CharithDombawala/Soil_Moisture_Meter/images/WhatsApp Image 2023-07-23 at 13.11.01.jpeg

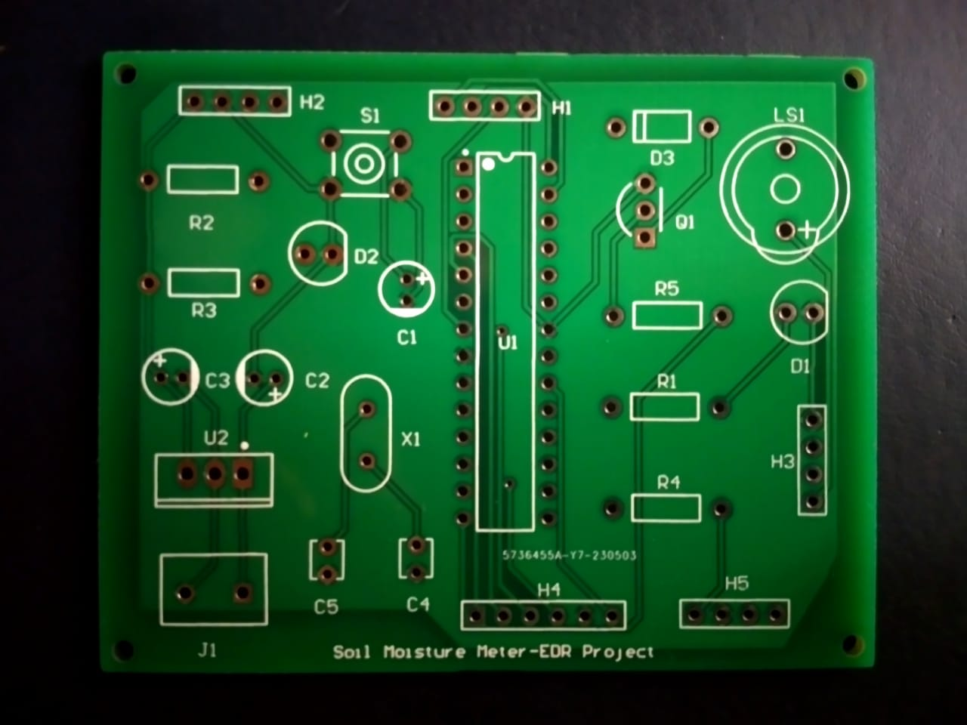
images/WhatsApp Image 2023-07-23 at 13.11.01.jpeg
