CharithDombawala/Soil_Moisture_Meter/README.md

# Soil_moisture_meter
project of electronic design Realization Module. schemetic designs are done by using Easy EDA
