CharithDombawala/Soil_Moisture_Meter/New enclosure Design/Soil Moisture Meter.pdf

# Soil Moisture Meter - Solidworks Design

# Index- 200148M

## - Hand Sketches

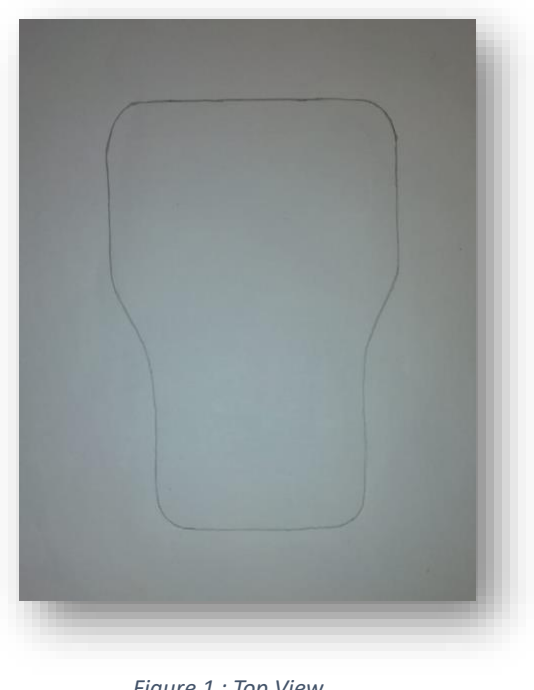
[picture p20: figure]

Figure 1 : Top View

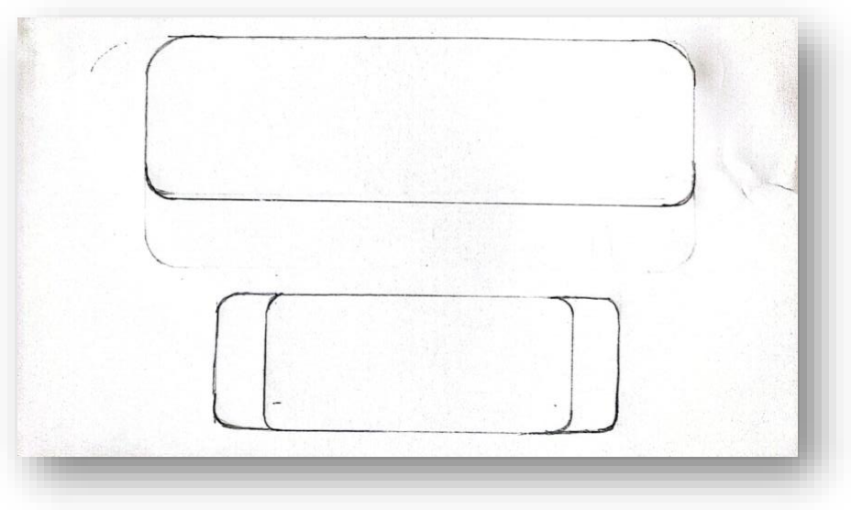
[picture p21: figure]

Figure 2 : Side view and Front view

- Imported Sketches into Solidworks.

### - 3D Design (Assembly)

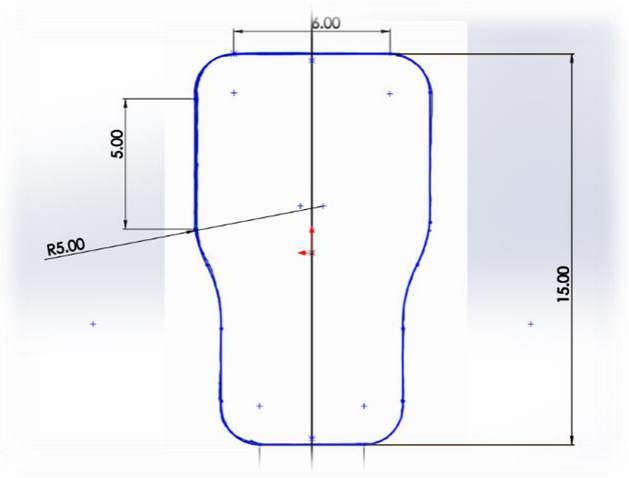
[picture p22: figure]

Figure 3 :imported hand sketch into solidworks

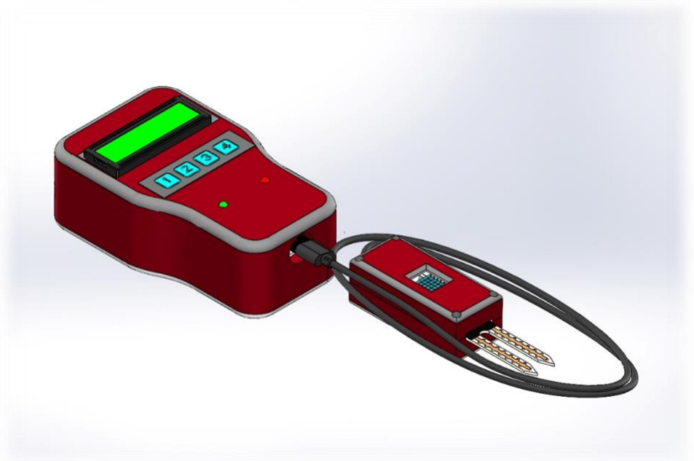
[picture p23: figure]
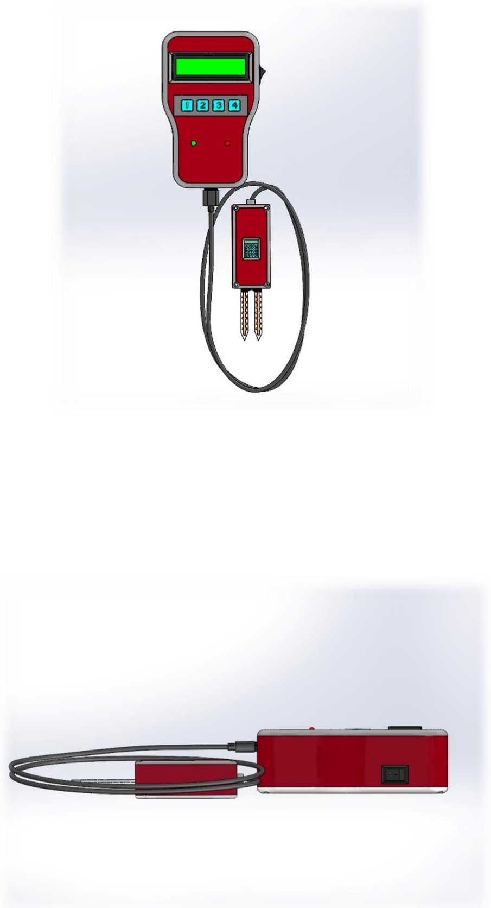
[picture p24: page 3]

### - Solid works Parts

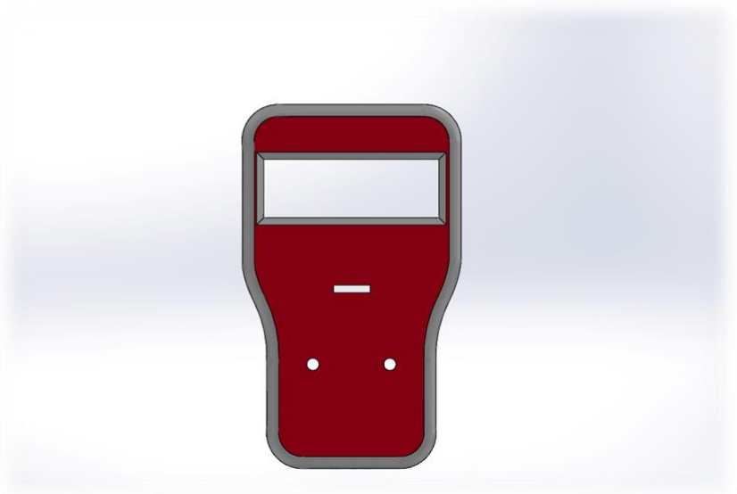
[picture p25: figure]

Figure 1: Top lid

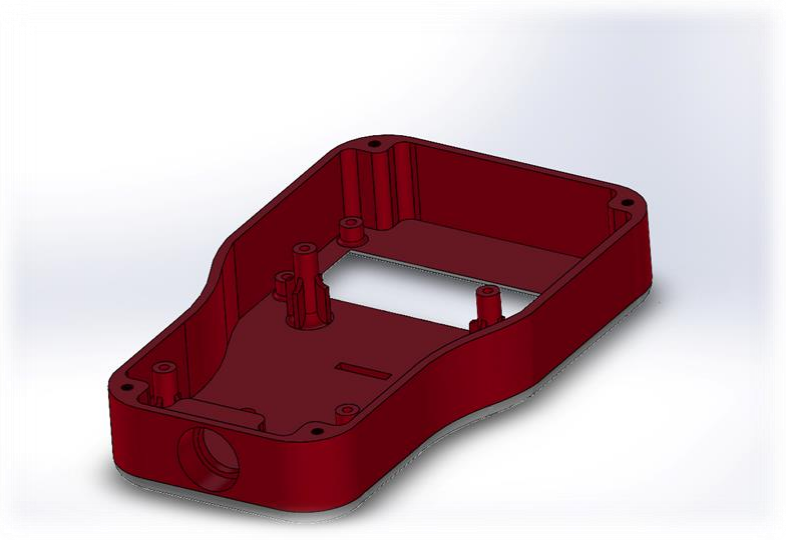
[picture p26: figure]

Figure 2: top lid inside

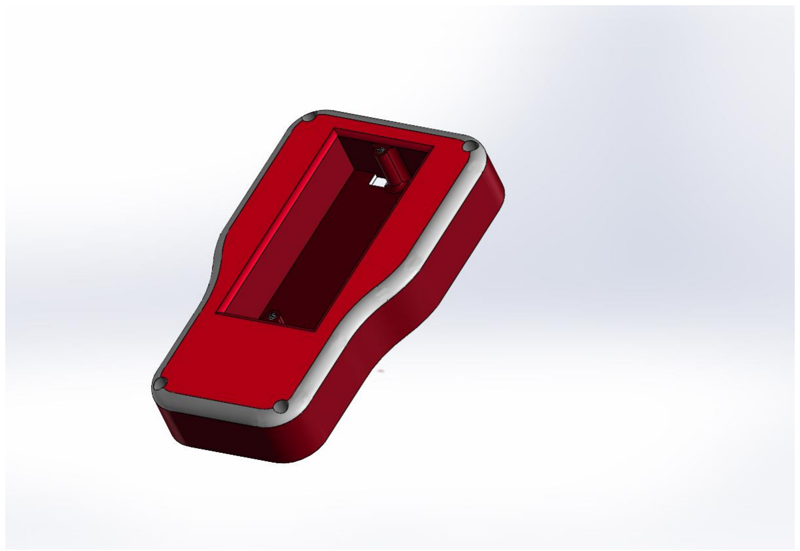
[picture p27: figure]
Figure 3: Top lid (Inside)

Figure 3: bottom lid

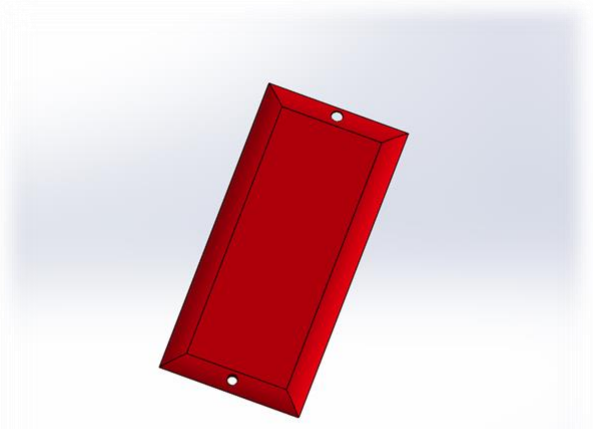
[picture p28: figure]
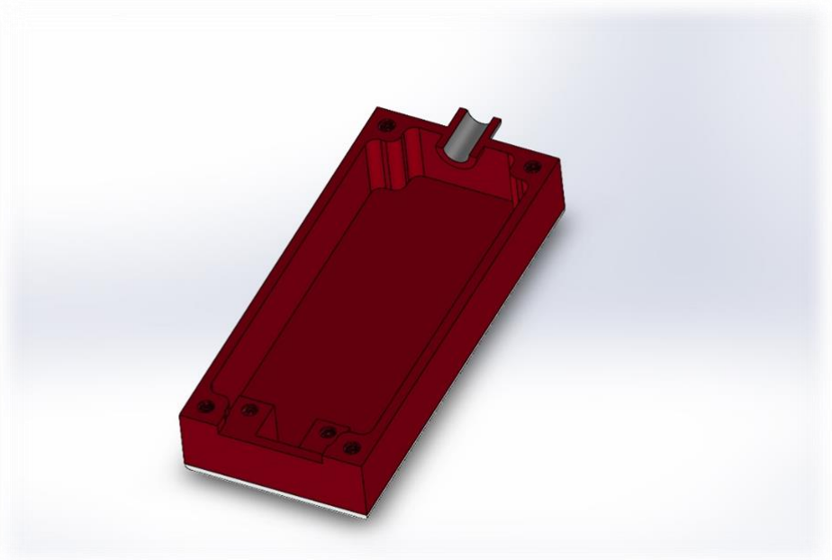
[picture p29: figure]

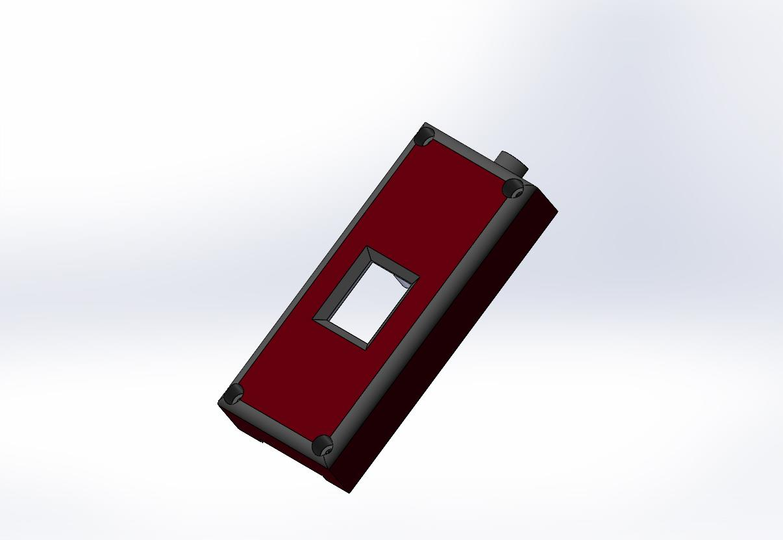
[picture p30: figure]
