CharithDombawala/Soil_Moisture_Meter/images/Screenshot 2023-07-23 112400.png

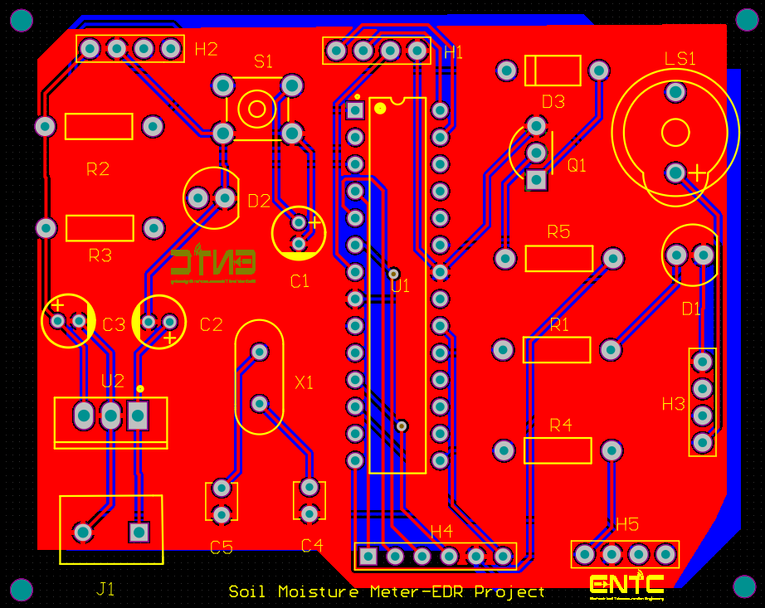
images/Screenshot 2023-07-23 112400.png
