CharithDombawala/Soil_Moisture_Meter/images/WhatsApp Image 2023-07-23 at 12.05.49.jpeg

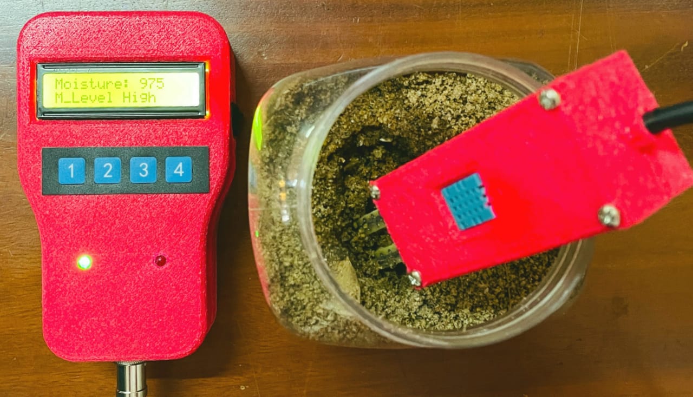
images/WhatsApp Image 2023-07-23 at 12.05.49.jpeg
