CharithDombawala/Soil_Moisture_Meter/New enclosure Design/sw photos/4.JPG

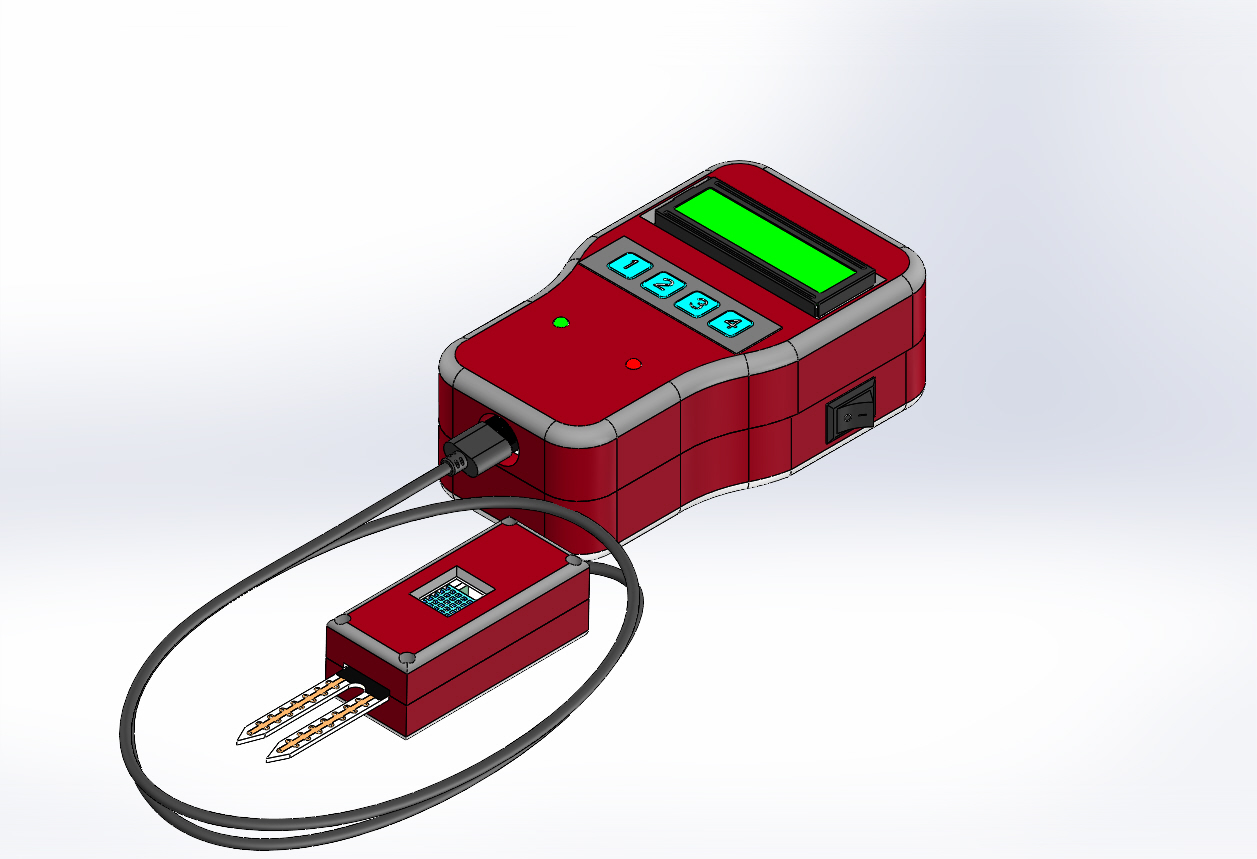
New enclosure Design/sw photos/4.JPG
