CharithDombawala/Soil_Moisture_Meter/New enclosure Design/sw photos/5.JPG

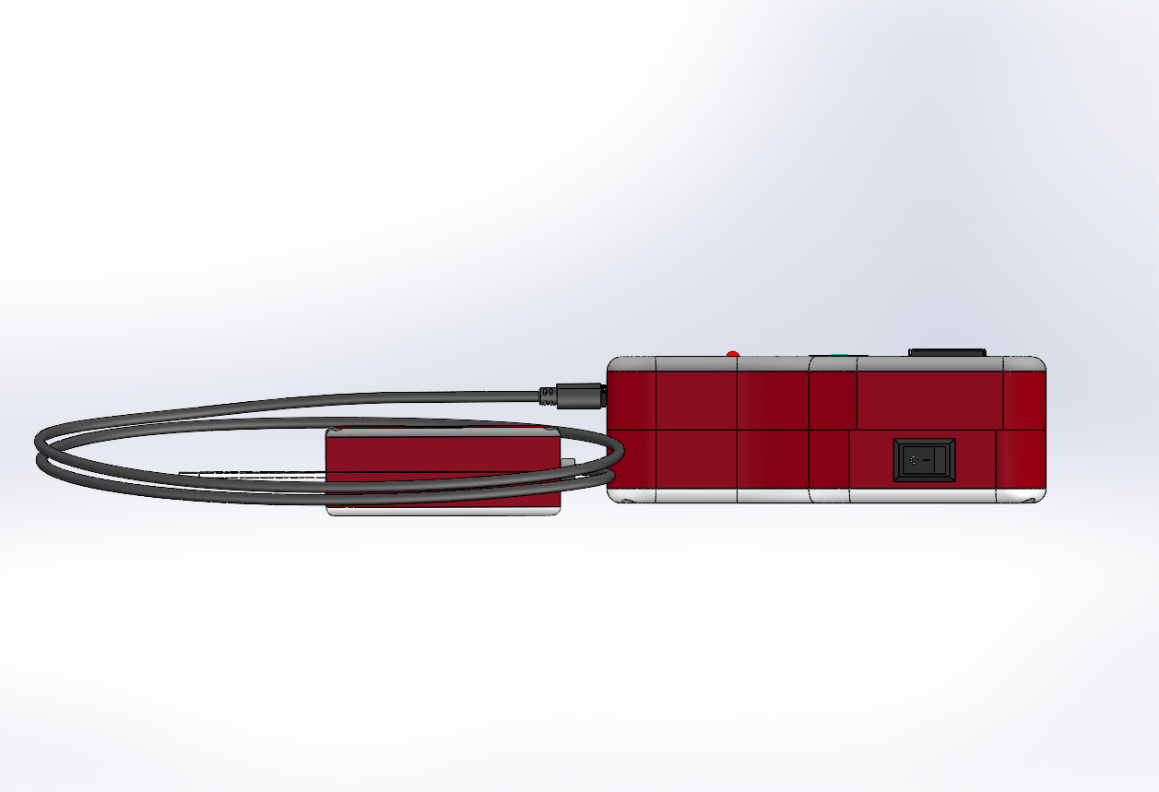
New enclosure Design/sw photos/5.JPG
