CharithDombawala/Soil_Moisture_Meter/New enclosure Design/sw photos/Assem2.JPG

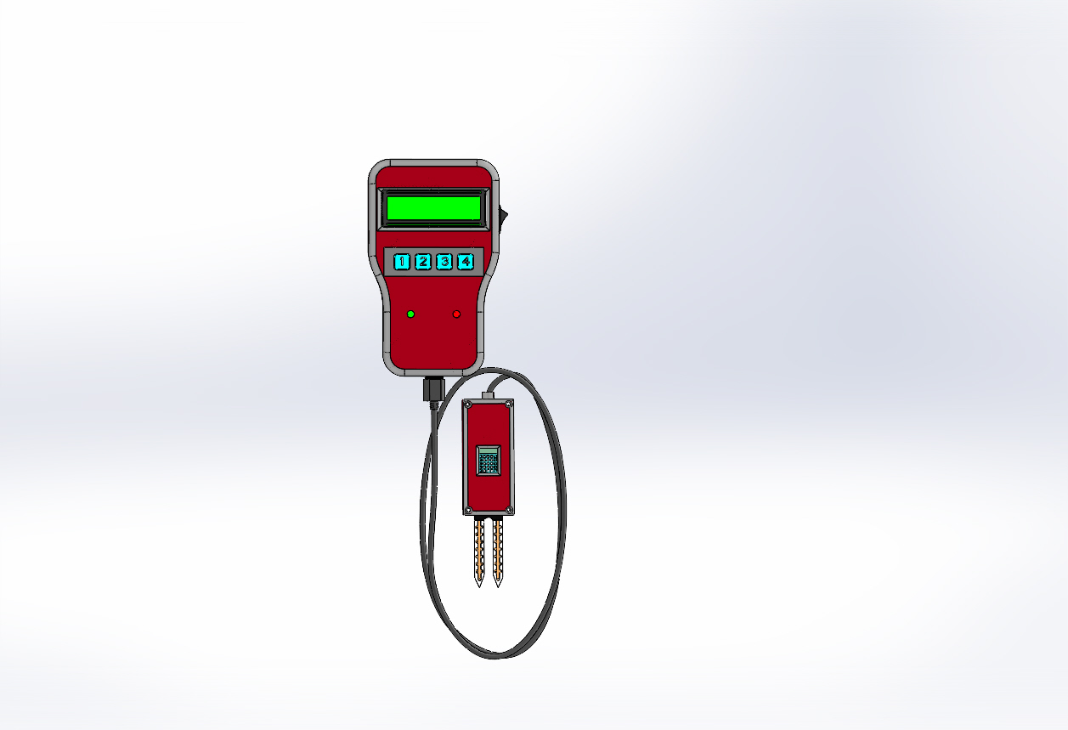
New enclosure Design/sw photos/Assem2.JPG
