CharithDombawala/Soil_Moisture_Meter/New enclosure Design/sw photos/bottum2.JPG

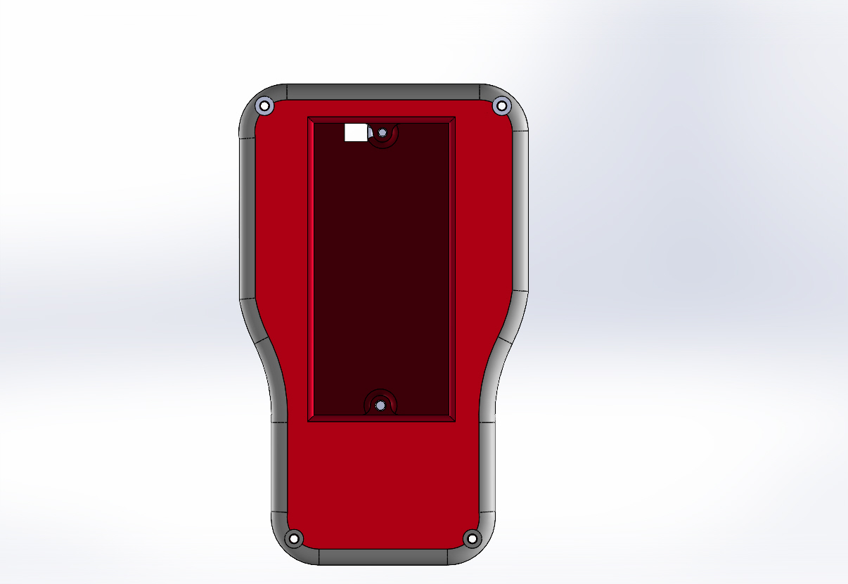
New enclosure Design/sw photos/bottum2.JPG
