CharithDombawala/Soil_Moisture_Meter/New enclosure Design/sw photos/sensorbottum.JPG

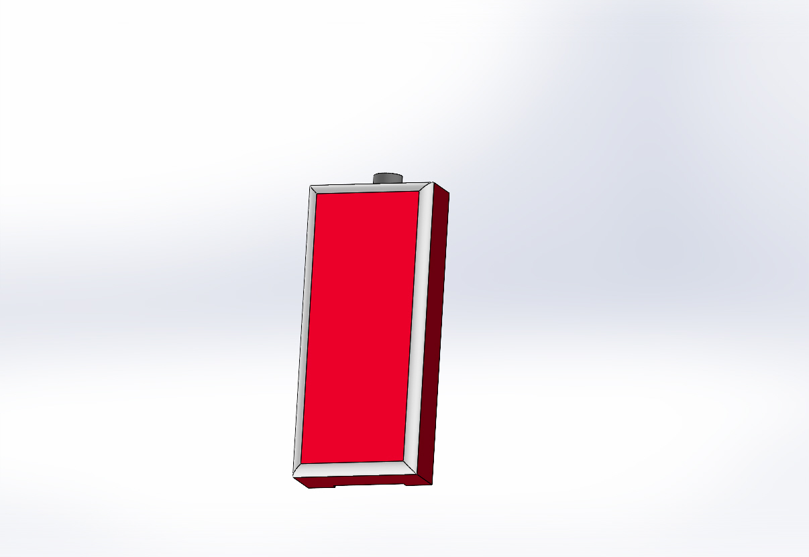
New enclosure Design/sw photos/sensorbottum.JPG
