CharithDombawala/Soil_Moisture_Meter/PCB design/diagrams/nvB82J1403449884.jpg

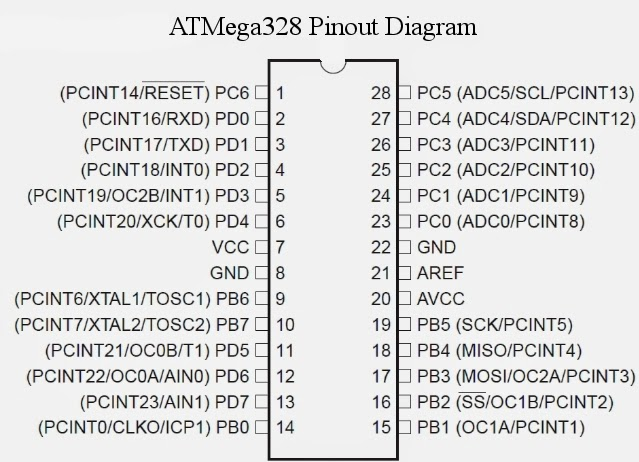
PCB design/diagrams/nvB82J1403449884.jpg
