CharithDombawala/Soil_Moisture_Meter/PCB design/diagrams/Screenshot (173).png

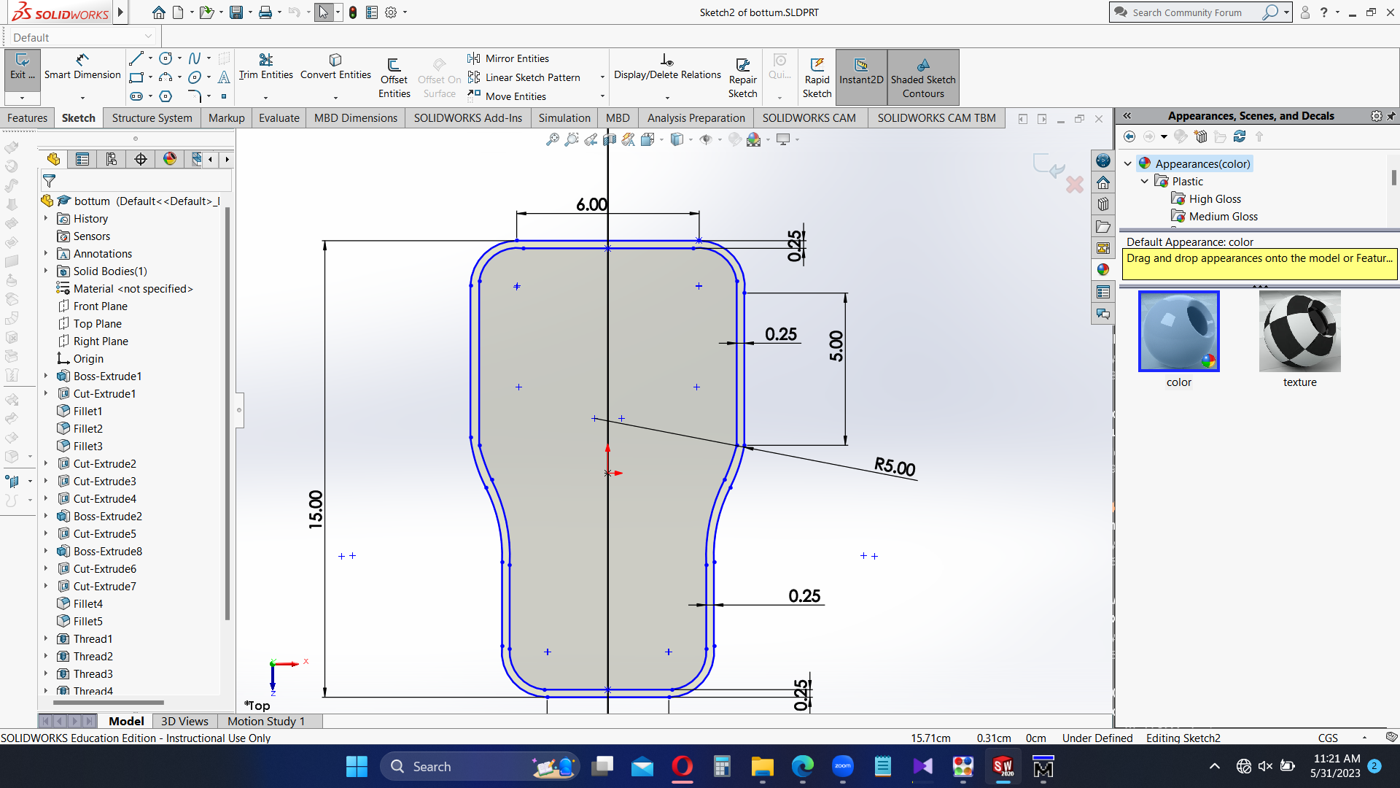
PCB design/diagrams/Screenshot (173).png
