CharithDombawala/Soil_Moisture_Meter/PCB design/diagrams/Screenshot.png

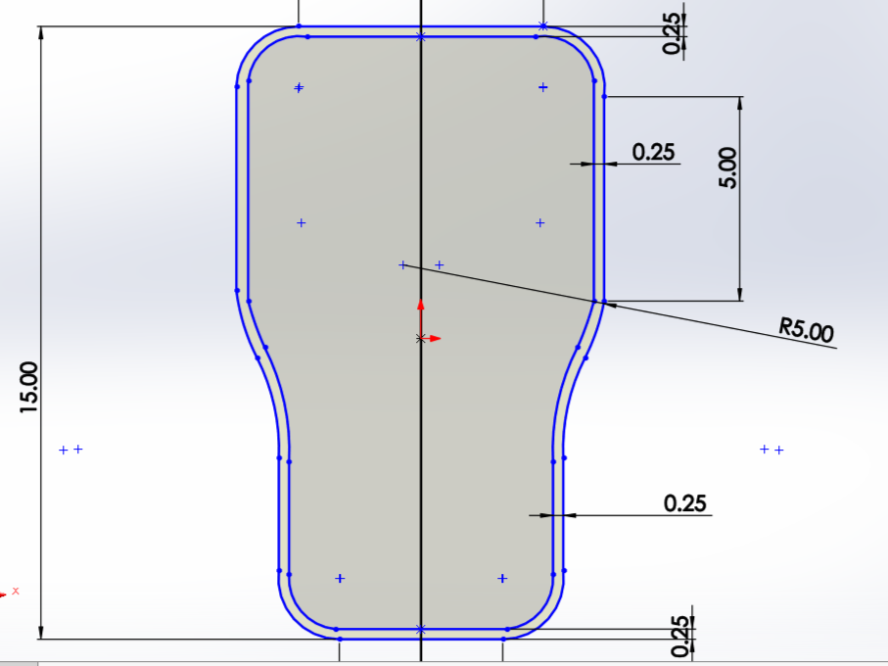
PCB design/diagrams/Screenshot.png
