CharithDombawala/Soil_Moisture_Meter/PCB design/diagrams/WhatsApp Image 2023-05-31 at 16.17.28 (1).jpeg

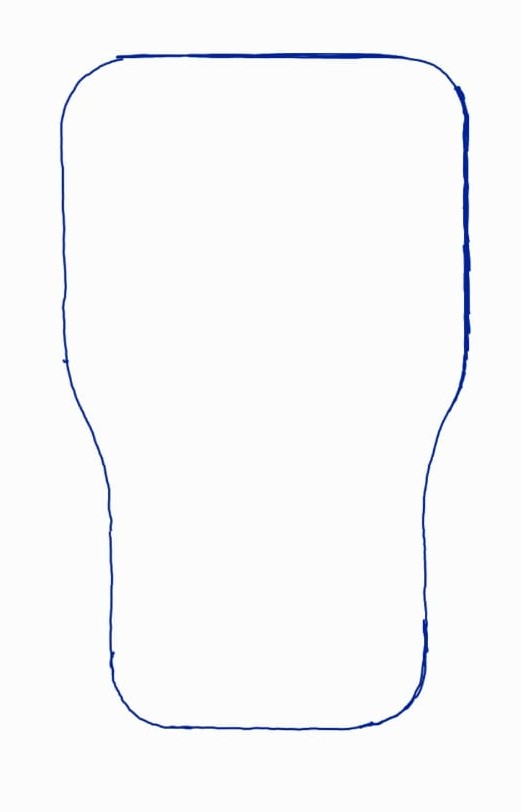
PCB design/diagrams/WhatsApp Image 2023-05-31 at 16.17.28 (1).jpeg
