CharithDombawala/Soil_Moisture_Meter/images/BOM_EDR Project_2023-07-23.csv

ID | Name | Designator | Footprint | Quantity | Manufacturer Part | Manufacturer | Supplier | Supplier Part | Price | Pins | EasyEDA | JLCPCB Part Class | Contributor | Manufacturer Part | Power | Tolerance | Value | image | link | sourceId | timeStamp | 制造商
1 | 0.33uF | C1 | CAP-TH_BD5.0-P2.00-D0.8-FD | 1 | 0.33uF 50V 5*11 | ValuePro | LCSC | C45097 | 0.007 | 2 |  | Extended Part
2 | 0.1uF | C2,C6 | CAP-TH_BD5.0-P2.00-D0.8-FD | 2 | 0.1UF 50V | ValuePro | LCSC | C28061 | 0.007 | 2 |  | Extended Part
3 | 22pF | C3,C4 | CAP-TH_L3.5-W3.0-P2.54-D0.8 | 2 | 22pf/50V 10% | ReliaPro | LCSC | C9316 |  | 2 |  | Extended Part
4 | 100nF | C5 | C0603 | 1 |  |  |  |  |  | 2 |  |  | LCEDA_Lib
5 | LED-0603_R | D1,D2 | LED0603_RED | 2 | 19-217/R6C-AL1M2VY/3T | EVERLIGHT(台湾亿光) | LCSC | C72044 | 0.016 | 2 |  |  | LCEDA_01
6 | LED-0603_G | D3 | LED0603_GREEN | 1 | 19-217/GHC-YR1S2/3T | EVERLIGHT(台湾亿光) | LCSC | C72043 | 0.027 | 2 |  |  | LCEDA_Lib
7 | LED | D4 | 5MM LED | 1 | 5mm LED |  |  |  |  | 2 |  |  | Axbri | 5mm LED
8 | 1N4001 | D5 | DO-41_BD2.4-L4.7-P8.70-D0.9-RD | 1 | 1N4001 | Diodes Incorporated | LCSC | C99656 |  | 2 |  | Extended Part | LCSC
9 | 4-PIN HEADER | H4,H6,H7 | HEADER - HEADER-FEMALE-2.54_1X4 | 3 |  |  | Sparkfun |  |  | 4 |  |  | Kang Yi Te
10 | 6-PIN HEADER | H8 | HDR-F-2.54_1X6 | 1 |  |  | LCSC | C40877 | 0.072 | 6 |  |  | LCEDA_Lib
11 | Power | J1 | CONN-TH_XHB-2A | 1 | XHB-2A Connector | BOOMELE | LCSC | C57981 | 0.01 | 2 |  | Extended Part |  |  |  |  |  | //image.lceda.cn/szlcsc/C57981.jpg
12 | AC Power Input | J2 | CONN-TH_XHB-2A | 1 | XHB-2A Connector | BOOMELE | LCSC | C57981 | 0.01 | 2 |  | Extended Part |  |  |  |  |  | //image.lceda.cn/szlcsc/C57981.jpg
13 | Output | J3 | CONN-TH_XHB-2A | 1 | XHB-2A Connector | BOOMELE | LCSC | C57981 | 0.01 | 2 |  | Extended Part |  |  |  |  |  | //image.lceda.cn/szlcsc/C57981.jpg
14 | BUZZER | LS1 | DIP-BUZZER-12X6 | 1 | BUZZERHMB1206-03 | HNDZ | LCSC | C96101 | 0.272 | 2 |  |  | วริศรา เกรียงไกรวัฒน์ /ทิพพะ
15 | BC547 | Q1 | TO-92-3_L4.9-W3.7-P2.54-L | 1 | BC547BTF | onsemi(安森美) | LCSC | C900798 | 0.092 | 3 |  | Extended Part | LCSC
16 | 1kΩ | R1 | AXIAL-0.4 | 1 | MFR0W4F2200A50 | UniOhm | LCSC | E57439 |  | 2 | E57439 |  |  |  | 1/4W | ±1% | Value
17 | 2kΩ | R2 | R0603 | 1 |  |  |  |  |  | 2 |  |  | LCEDA_Lib
18 | 470Ω | R3,R4 | R0603 | 2 |  |  |  |  |  | 2 |  |  | LCEDA_Lib
19 | 10kΩ | R5 | R0603 | 1 |  |  |  |  |  | 2 |  |  | LCEDA_Lib
20 | 4.7kΩ | R6 | AXIAL-0.4 | 1 | MFR0W4F2200A50 | UniOhm | LCSC | E57439 |  | 2 | E57439 |  |  |  | 1/4W | ±1% | Value
21 | 10KΩ | R7 | AXIAL-0.4 | 1 | MFR0W4F2200A50 | UniOhm | LCSC | E57439 |  | 2 | E57439 |  |  |  | 1/4W | ±1% | Value
22 | 330Ω | R8 | AXIAL-0.4 | 1 | MFR0W4F2200A50 | UniOhm | LCSC | E57439 |  | 2 | E57439 |  |  |  | 1/4W | ±1% | Value
23 | 220Ω | R9 | AXIAL-0.4 | 1 | MFR0W4F2200A50 | UniOhm | LCSC | E57439 |  | 2 | E57439 |  |  |  | 1/4W | ±1% | Value
24 | K2-3.6×6.1_SMD | S1 | KEY-SMD_2P-L6.2-W3.6-LS8.0 | 1 | K2-1107ST-A4SW-06 |  | LCSC | C118141 | 0.069 | 2 |  |  | LCEDA_Lib |  |  |  |  |  |  |  |  | 韩国韩荣
25 | Reset | S2 | KEY-TH_4P-L6.0-W6.0-P4.50 | 1 | button6*6*8.5 | ReliaPro | LCSC | C59980 | 0.016 | 4 |  |  |  |  |  |  |  | http://image.lceda.cn/szlcsc/C59980.jpg
26 | LM7805 | U1 | TO-220-3_L10.0-W4.5-P2.54-L | 1 | L7805CV-DG | STMicroelectronics | LCSC | C3795 | 0.259 | 3 |  |  | LCEDA_Lib
27 | MCP73831 | U2 | SOT-23-5_L3.0-W1.7-P0.95-LS2.8-BR | 1 | MCP73831T-2ATI/OT | MICROCHIP(美国微芯) | LCSC | C14879 | 1.034 | 5 |  | Extended Part
28 | SMDESP8266-12F | U3 | WIFIM-SMD_22P-L24.0-W16.0-P2.00 | 1 | SMDESP8266-12F | null | LCSC | C9900003458 |  | 22 |  | Extended Part | LCSC
29 | ATMEGA328P-PU | U4 | DIP-28_L34.6-W7.3-P2.54-LS10.2-BL | 1 | ATMEGA328P-PU | MICROCHIP(美国微芯) | LCSC | C33901 | 4.249 | 28 |  | Extended Part | LCSC |  |  |  |  |  |  | Oic6oiASL | 1451725987
30 | 16MHz | X1 | CRYSTAL-TH_L10.8-W4.5-P4.88 | 1 | ATS16A | CTS(西迪斯) | LCSC | C1669847 | 0.123 | 2 |  |  | lcsc |  |  |  |  |  | https://atta.szlcsc.com/upload/public/pdf/source/20200318/C487700_6E42144C1E843ECF848E205586EC895F.pdf
