CharithDombawala/Soil_Moisture_Meter/PCB design/History/Soil_Moisture_meter/SW/SoilMoistureMeter.SLDASM

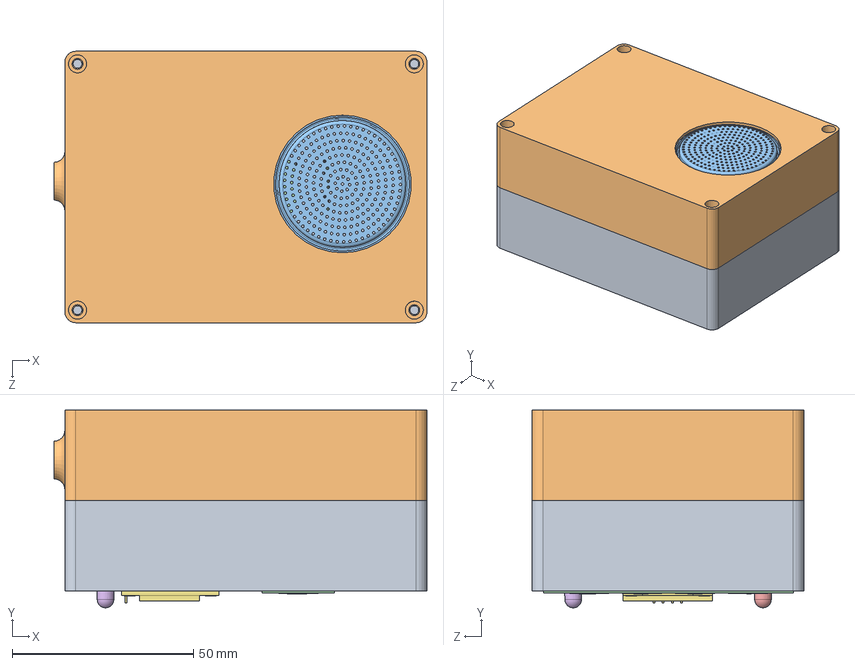
[picture p42: CAD file, 2023-05-14]
PCB design/History/Soil_Moisture_meter/SW/SoilMoistureMeter.SLDASM
103.0 x 54.6 x 75.0 mm
toplid
bottumlid
rooster 1
1x4-keypad.stp
WP1513GT.stp
WP1513IT.stp
SSD1315_OLED_Display v4.step
