CharithDombawala/Soil_Moisture_Meter/New enclosure Design/Parts that I designed/sensortop.SLDPRT

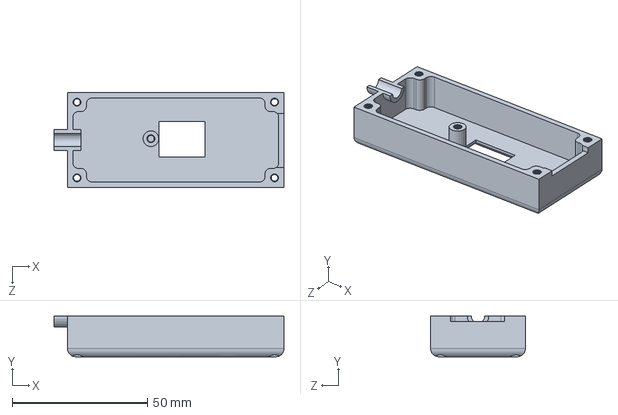
[picture p43: CAD file, 2023-06-07]
New enclosure Design/Parts that I designed/sensortop.SLDPRT
85.0 x 15.0 x 35.0 mm
