CharithDombawala/Soil_Moisture_Meter/PCB design/History/Soil_Moisture_meter/SW/toplid.SLDPRT

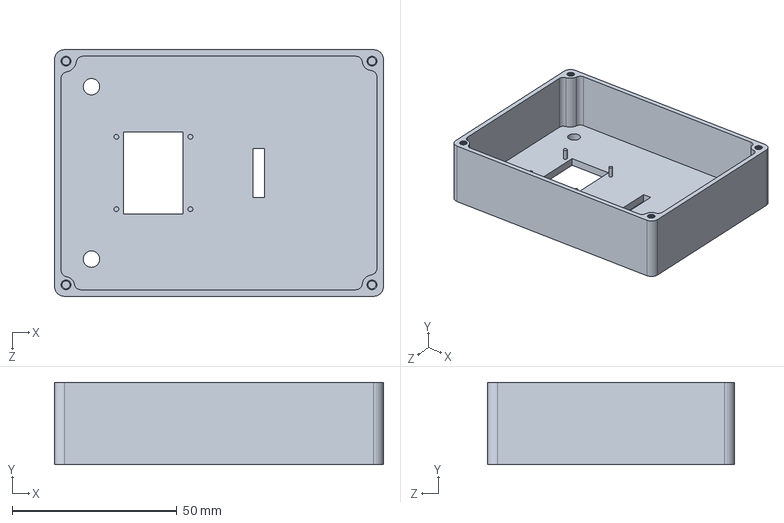
[picture p44: CAD file, 2023-05-14]
PCB design/History/Soil_Moisture_meter/SW/toplid.SLDPRT
100.0 x 25.0 x 75.0 mm
