CharithDombawala/Soil_Moisture_Meter/New enclosure Design/Parts that I designed/top.SLDPRT

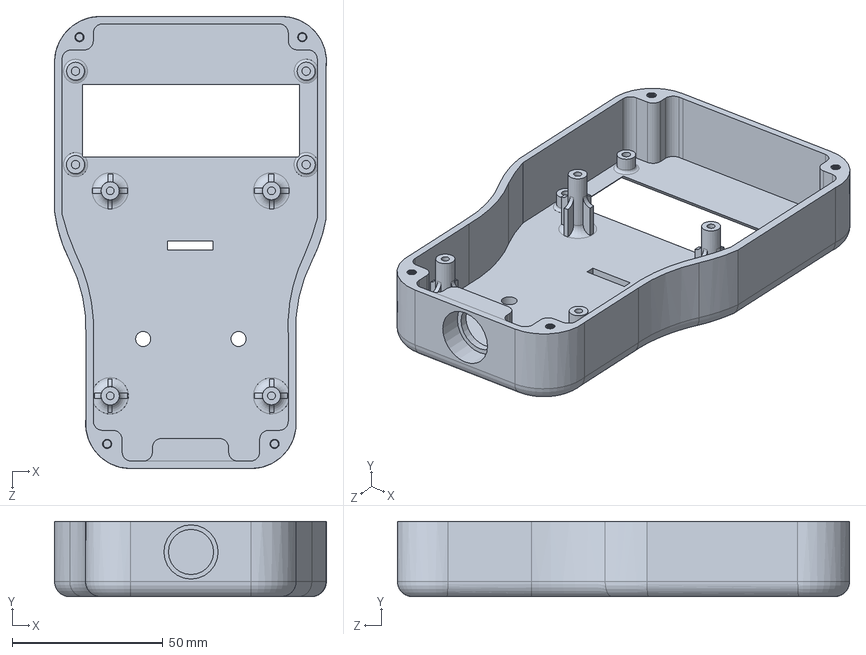
[picture p45: CAD file, 2023-06-07]
New enclosure Design/Parts that I designed/top.SLDPRT
90.2 x 25.0 x 150.0 mm
