CharithDombawala/Soil_Moisture_Meter/New enclosure Design/Parts that I designed/bottum.SLDPRT

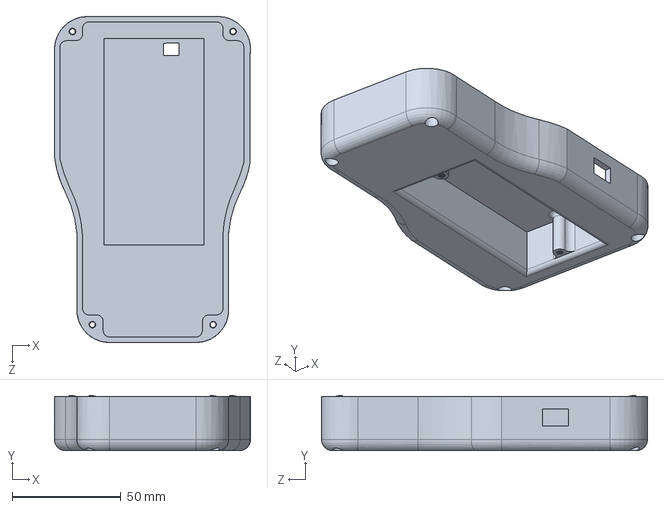
[picture p46: CAD file, 2023-06-07]
New enclosure Design/Parts that I designed/bottum.SLDPRT
90.2 x 25.4 x 150.0 mm
