CharithDombawala/Soil_Moisture_Meter/PCB design/History/Soil_Moisture_meter/SW/bottumlid.SLDPRT

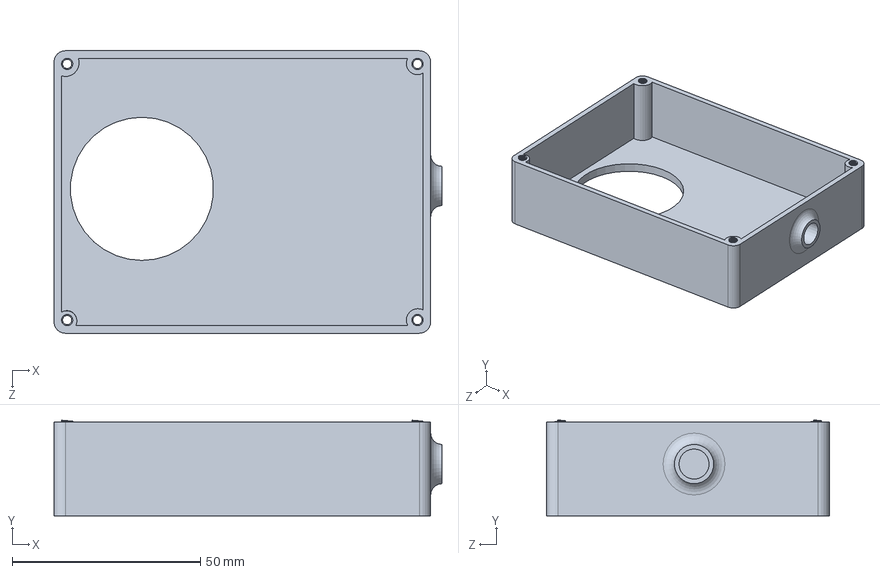
[picture p47: CAD file, 2023-05-14]
PCB design/History/Soil_Moisture_meter/SW/bottumlid.SLDPRT
103.0 x 25.5 x 75.0 mm
