CharithDombawala/Soil_Moisture_Meter/New enclosure Design/Parts that I designed/BatteryLid.SLDPRT

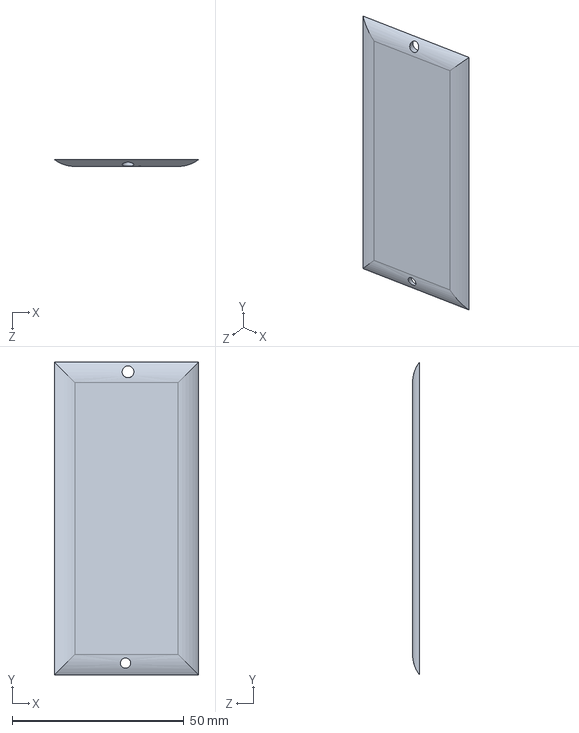
[picture p48: CAD file, 2023-06-07]
New enclosure Design/Parts that I designed/BatteryLid.SLDPRT
42.0 x 91.0 x 2.00 mm
