CharithDombawala/Soil_Moisture_Meter/PCB design/History/Soil_Moisture_meter/SW/rooster 1.sldprt

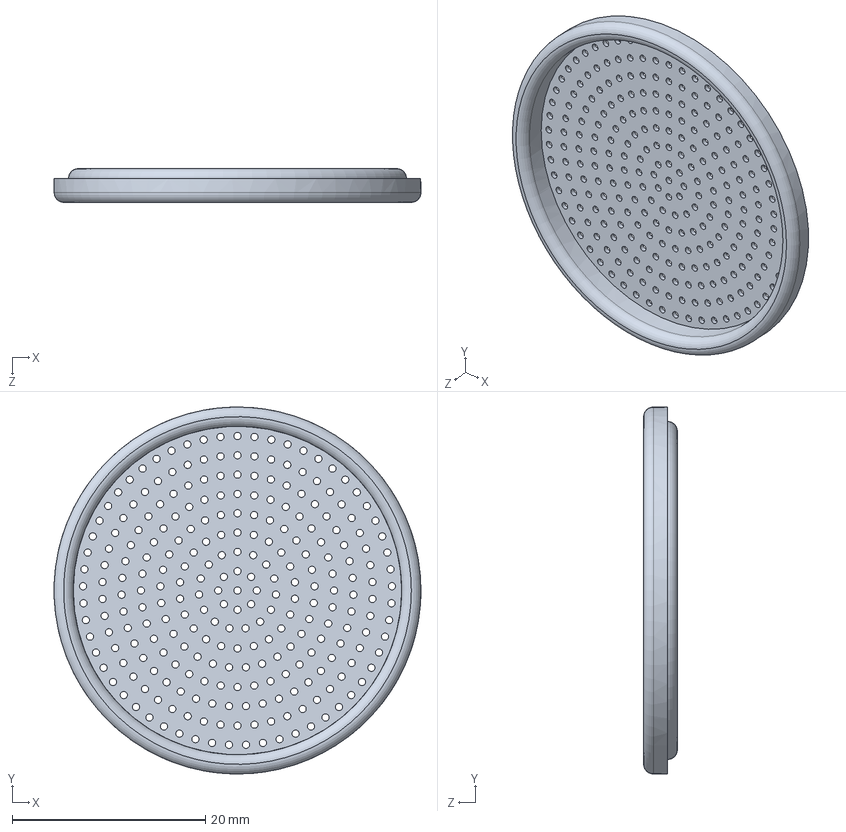
[picture p49: CAD file, 2023-05-14]
PCB design/History/Soil_Moisture_meter/SW/rooster 1.sldprt
38.0 x 38.0 x 3.50 mm
