CharithDombawala/Soil_Moisture_Meter/PCB design/History/Soil_Moisture_meter/SW/SSD1315_OLED_Display v4.step.SLDPRT

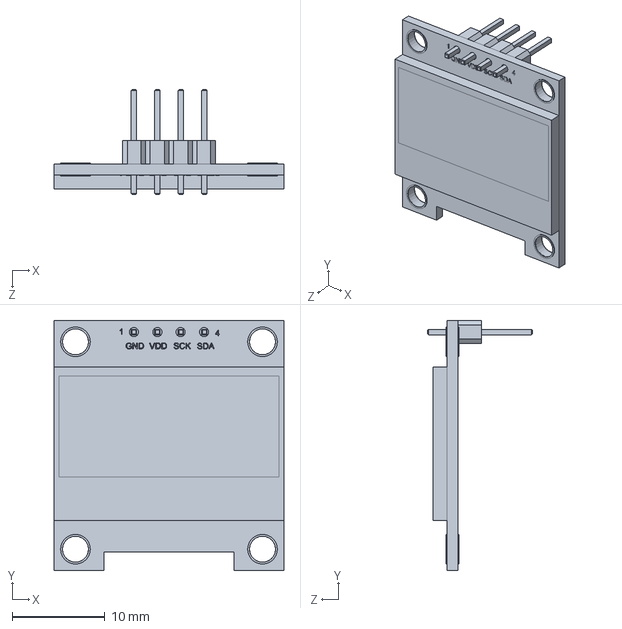
[picture p50: CAD file, 2023-05-14]
PCB design/History/Soil_Moisture_meter/SW/SSD1315_OLED_Display v4.step.SLDPRT
24.8 x 27.0 x 11.3 mm
