CharithDombawala/Soil_Moisture_Meter/New enclosure Design/Parts from GrabCad/RockerSwitch.SLDPRT

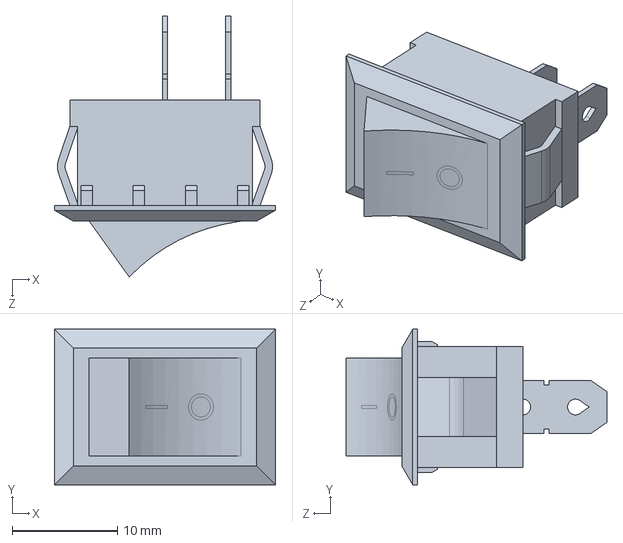
[picture p51: CAD file, 2023-06-07]
New enclosure Design/Parts from GrabCad/RockerSwitch.SLDPRT
21.0 x 14.8 x 24.8 mm
