CharithDombawala/Soil_Moisture_Meter/New enclosure Design/Parts from GrabCad/Wire.sldprt

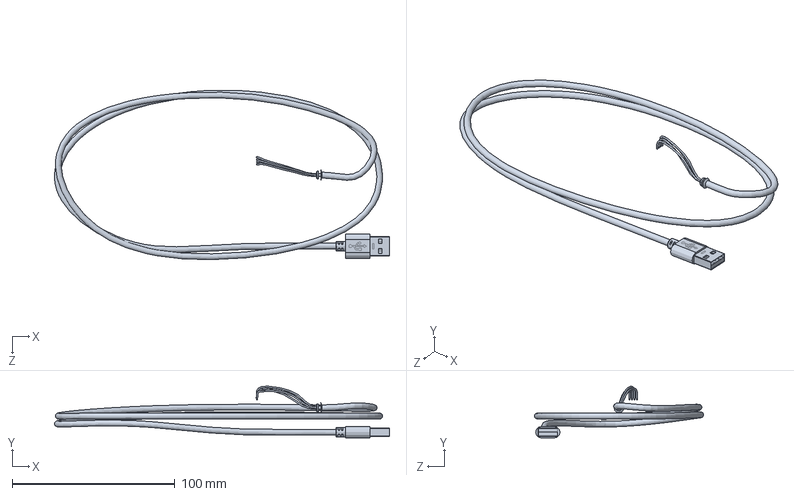
[picture p52: CAD file, 2023-06-07]
New enclosure Design/Parts from GrabCad/Wire.sldprt
205.7 x 31.8 x 103.9 mm
