CharithDombawala/Soil_Moisture_Meter/New enclosure Design/Parts from GrabCad/DHT11.SLDPRT

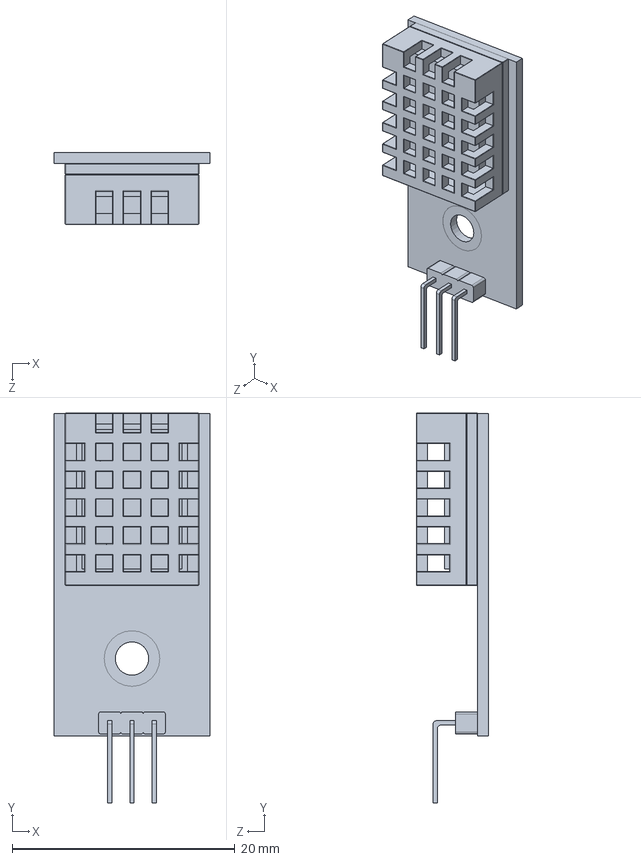
[picture p53: CAD file, 2023-06-07]
New enclosure Design/Parts from GrabCad/DHT11.SLDPRT
14.0 x 35.0 x 6.50 mm
