CharithDombawala/Soil_Moisture_Meter/New enclosure Design/Parts from GrabCad/Soil-Moisture-Sensor-Probe.stp.SLDPRT

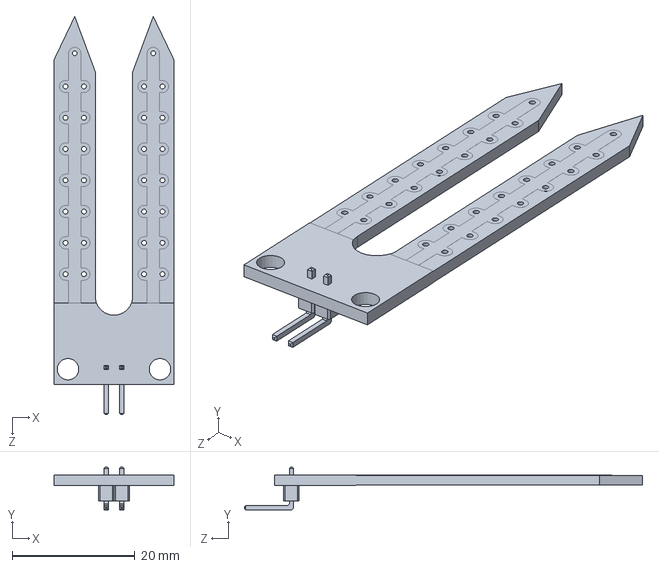
[picture p54: CAD file, 2023-06-07]
New enclosure Design/Parts from GrabCad/Soil-Moisture-Sensor-Probe.stp.SLDPRT
19.5 x 7.00 x 64.9 mm
