CharithDombawala/Soil_Moisture_Meter/New enclosure Design/Parts from GrabCad/WP1513IT.stp.SLDPRT

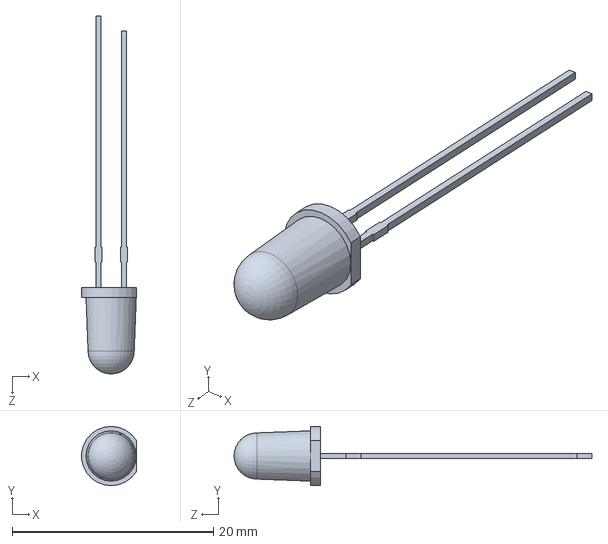
[picture p55: CAD file, 2023-05-14]
New enclosure Design/Parts from GrabCad/WP1513IT.stp.SLDPRT
5.43 x 5.90 x 35.6 mm
