CharithDombawala/Soil_Moisture_Meter/New enclosure Design/Parts from GrabCad/1x4-keypad.stp.SLDPRT

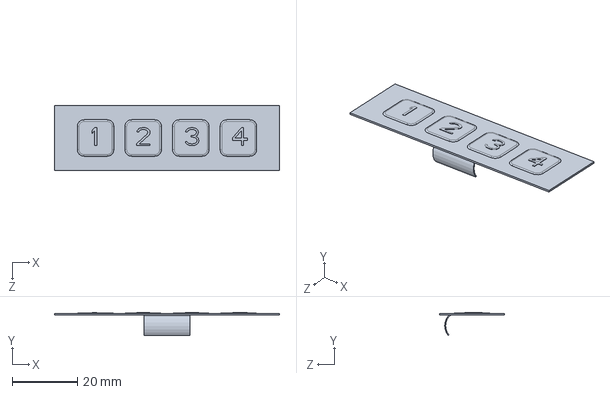
[picture p56: CAD file, 2023-05-14]
New enclosure Design/Parts from GrabCad/1x4-keypad.stp.SLDPRT
69.0 x 7.10 x 20.0 mm
