CharithDombawala/Soil_Moisture_Meter/(list of files, cad)

Other CAD files:
New enclosure Design/Parts that I designed/sensorbottum.SLDPRT
New enclosure Design/Parts from GrabCad/WP1513GT.stp.SLDPRT
