CharithDombawala/Soil_Moisture_Meter/PCB design/Gerber_PCB_EDR Project_2023-04-19/How-to-order-PCB.txt

How to Order PCB

Please refer to:
https://docs.easyeda.com/en/PCB/Order-PCB
