CharithDombawala/Soil_Moisture_Meter/(list of files, drawings)

Other design files:
PCB design/Autorouter_PCB_EDR Project_2023-04-19.dsn
PCB design/PCB_EDR Project.pcbdoc
PCB design/PCB_PCB_EDR Project_2023-04-19.json
PCB design/SCH_EDR Project_2023-04-19.json
PCB design/Schematic_2023-04-19.schdoc
Sent to JLC PCB/PCB_EDR Project.pcbdoc
