CharithDombawala/Soil_Moisture_Meter/(commit log)

2023-04-14 upto schemetic design
    [BOM_EDR Project_2023-04-14.csv, SCH_EDR Project_2023-04-14.json, Schematic_2023-04-14.schdoc]
2023-04-17 for atmega328p chip
    [BOM_EDR Project_2023-04-17.csv, SCH_EDR Project_2023-04-17.json, Schematic_2023-04-17.schdoc]
2023-04-19 Final design
    [Autorouter_PCB_EDR Project_2023-04-19.dsn, BOM_EDR Project_2023-04-14.csv, BOM_EDR Project_2023-04-17.csv, BOM_PCB_EDR Project_2023-04-19.csv, PCB_PCB_EDR Project_2023-04-19.json, SCH_EDR Project_2023-04-14.json, SCH_EDR Project_2023-04-19.json, Schematic_2023-04-14.schdoc]
2023-04-19 internediate design files
    [BOM_EDR Project_2023-04-14.csv, BOM_EDR Project_2023-04-17.csv, SCH_EDR Project_2023-04-14.json, SCH_EDR Project_2023-04-17.json, Schematic_2023-04-14.schdoc, Schematic_2023-04-17.schdoc]
2023-05-20 with PCB
    [PCB_EDR Project.pcbdoc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]
2023-06-12 Up to prototype evaluation
